t8rn8r/organ-building-for-amateurs/paper organ pipes.odt

# Wicks’ method to make paper organ pipes

Wicks contrived this system of making organ pipes to make it easier and cheaper for the amateur to build their first organ pipes. These paper pipes are meant to imitate metal pipes, but without the need for expensive and difficult metalworking techniques. Wicks lists several advantages to his system for making paper organ pipes:

- They’re cheap. Really, really cheap.
- They’re very light.
- They’re easy to make.
- They require no special tools.
- They have no risk of air leakage since they don’t have long seams.
- They take up the same space as metal pipes.
- They are stronger than metal pipes, and aren’t as easily damaged.
- You can test your pipes before their completion to ensure they will sound.

In practice, this technique has been used in some historical organs, but hasn’t been widely adopted by any major organ builder that I know of. Regardless, making paper pipes is a great way to get into building your own pipe organ.

## Making your first pipe

Wicks suggests starting by making a single pipe that sounds at G5. In the future, you’ll make several sets of pipes at the same time, but the educational and practical value of making a single pipe before investing time and effort into maximizing efficiency of production far outweighs the small amount of time it takes to make. Consider this the “practice round”. Even if you fail, you’ll still end up with a fun keepsake!

### Using the scale

According to the scale you made in a previous chapter, go to the row for G5 to find that it has a speaking length (the length above the mouth of the pipe) of 8-1/2” and a diameter of 23/32”. Don’t worry too much about getting the diameter of the pipe within a 1/32” tolerance. If you make it 3/4” or 11/16” it will make no audible difference in the finished product.

### Forming a mandrel

You will wrap paper around a mandrel to form your pipe. The mandrel should be the exact diameter of the desired pipe, according to the scale you use. For our pipe of 23/32” diameter, we want to make a mandrel of 23/32”.

First, take a dowel with a diameter smaller than the desired pipe and a length much longer than the desired pipe and wrap paper (from a paper roll) around it until it measures exactly 23/32” in diameter. This paper is not your pipe. It is your mandrel. Wrap it tightly and evenly so that it forms a perfect cylinder.

Once you achieve the desired diameter, cut the paper from the paper roll then glue or tape the edge on your mandrel so that you’re left with a cylinder with the exact diameter of your pipe.

### Calculating circumference

First, let’s do some math. The circumference of the pipe is given by circumference = π × diameter. Therefore, the circumference of this pipe is very close to 2-1/4”. We’ll use this number for the rest of our calculations below.

### Forming the pipe

Now it’s time to make your pipe. Using the paper you intend to use for your pipework, cut a piece that is slightly wider than your finished pipe is long. For G5, which is 8-1/2” long, cut the paper about 9” wide. Cut the paper long enough to go around the mandrel about 4 times around the mandrel. For a circumference of 2-1/4”, that length is 9”. (It’s convenient that this pipe uses a square piece of paper. No other pipes will come out this way.)

Mark the distance one circumference (2-1/4” in this case) from the edge of the paper. You can use measuring tools, or simply wrap the paper once around the mandrel for this. Spread glue on the remaining 7-3/4” of paper and let the glue soak into the paper for a little bit, but don’t let it dry.

Finally, wrap the paper around the mandrel so that the part with no glue is in direct contact with the surface of the mandrel. If you fail to do this, your pipe will be glued to the mandrel and never come off.

Press firmly all around your newly formed pipe while its still on the mandrel. You can do this by rolling it against your workbench like a rolling pin.
