t8rn8r/organ-building-for-amateurs/organ specifications.odt

# Organ specifications

When planning your organ, keep in mind that even a small organ will likely require up to year of steady work to finish. However, a medium or large organ doesn’t require much more time to build than a small one. This is largely due to the fact that the mechanical action of a large organ is the same as that of a small organ. The the most significant additional time investment for building a larger organ is the time required to build the additional pipework.

The following specifications (taken directly from Wicks’ original book) provide a few suggested specifications for your first (and second, and third) organ project. Note that he assumes a manual range of 56 keys, from C2 through G6.

Instrument 1: Rank specifications for a general instrument with a manual range of 56 notes and a pedal range of 25 notes

Rank | Number of Pipes | Range | Tone
Open diapason | 44 | C3-G6 | 8’
Stopped Diapason, bass | 12 | C2-B2 | 8’
Stopped diapason, treble | 44 | C3-G6 | 8’
Flute (for Principal) | 56 | C3-G7 | 4’
Keraulophon (small scale) | 44 | C3-G6 | 8’
Flageolet (for Fifteenth) | 56 | C4-G8 | 2’
Bourdon (pedals) | 25 | C1-C3 | 16’
Total: | 281 | C1-G8
Couplers: | Octave Great to Pedal
Enclosures: | Enclose all in general swell
Size: | ~6’6” wide x 9’ high x 3’ deep
Notes: | There will be room for another stop of 12 notes in the bass, in which a violoncello stop may be inserted. If the Bourdon were omitted, it would greatly reduce the size of the instrument. A nice little instrument could be made from only the first four or five stops.

Instrument 2: Rank specification for a two manual instrument with a manual range of 56 keys and a pedal range of 25 keys

Rank | Number of Pipes | Range | Tone
Great organ
Open diapason | 44 | C3-G6 | 8’
Stopped Diapason, bass | 12 | C2-B2 | 8’
Principal (flute) | 56 | C3-G7 | 4’
Flageolet | 56 | C4-G8 | 2’
Swell organ
Lieblich Gedacht | 56 | C2-G6 | 8’
Keraulophon | 44 | C3-G6 | 8’
Pedal organ
Bourdon | 25 | C1-C3 | 16’
Total: | 293 | C1-G8
Couplers: | Swell to Great Swell to great octave Great to Pedal
Enclosures: | Enclose all in general swell
Size: | ~6’6” wide x 9’ high x 3’6” deep

Instrument 3: Rank specification for a smaller two manual instrument with a manual range of 44 keys and a pedal range of 25 keys

Rank | Number of Pipes | Range | Tone
Great organ
Open diapason | 44 | C3-G6 | 8’
Stopped Diapason, bass | 12 | C2-B2 | 8’
Swell organ
Lieblich Gedacht | 44 | C3-G6 | 8’
Flute (for Principal, small scale) | 44 | C3-G6 | 8’
Total: | 144 | C2-G6
Couplers: | Swell to Great Swell to great octave Octave on Great
Enclosures: | Enclose all in general swell
Size: | ~6’6” wide x 9’ high x 3’6” deep
Notes: | The Pedal Bourdon may, or may not, be added, according to the will of the builder If it is added, also add a coupler for Great to Pedal

## A note on octave couplers

If using octave couplers on any organ, add an octave to each stop they affect so that every note on the keyboard may be affected by the coupler.
