t8rn8r/organ-building-for-amateurs/tools and skills.odt

# Required tools and workspace, skills, and supplies

There’s no project more interesting or fascinating than building a musical instrument. When building pianos, trumpets, saxophones, violins, guitars, or any number of other instruments, most of the fun is taken away from the would-be builder because the actual music-producing parts of the instruments must be manufactured by professionals using tools that are inaccessible to the average person. Not so with the organ! Even thought the pipe organ is the king of instruments, every part of it can be built by a motivated amateur.

## Tools and workspace requirements

Here are the recommended tools and workspace requirements for the amateur organ builder (Table 1.1). If there’s a tool listed here that you’re unfamiliar with, a quick online search will likely provide clarity and a place to procure that tool.

Note that you don’t need to go out and purchase all of these tools at once! You may find it beneficial to acquire them as you have need during your project.

To obtain tools that you don’t already own, try exploring your local “tool library,” makerspace, community workshop, or your next door neighbor’s garage. You never know what you might find!

Local craftsmen and women are often very happy to help a new hobbyist get started safely and quickly.

As a last resort, you can find any of these tools at your local carpentry shop or home improvement store.

Table 1.1: Tools and workspace requirements for amateur organ building

- A workbench, at least 6’ long.
- Assorted clamps for holding parts while working and gluing
- Saws for cutting planks of wood
  - A table saw would be most useful for this purpose
- Planes (either power planer or a set of manual hand planes)
  - If using a power planer, you will likely also want a power jointer
- A router for cutting grooves
- A set of hand chisels
  - 1/4”, 3/8”, 5/8”, and 1-1/4” at the minimum
- 3/8” mortise chisel or mortiser
- A set of gouges
  - at least one 1/2”, and ¾”
- A drill with bits ranging from 3/16” to 1-1/4”
  - an expanding bit is optional
  - get a few very small bits for precision drilling and making starter holes
- Screwdrivers and/or screw driving bits for your drill
- Paint brushes, large and small
- Large T-square (at least 30”)
- Carpenter’s square (9-12”)
- Soldering iron
- Wire cutters
- Round nose pliers
- Needle-nose pliers
- Measuring tools
  - Tape measure
  - Precision calipers (at least 1/32” precision)
- Sharp scissors for cutting paper

## Required supplies

The general supplies needed for building an organ are listed in Table 1.2. This list isn’t exhaustive, but provides a general overview of what will be required.

Table 1.2: General supplies required for amateur organ building

- High quality (furniture quality) hardwood
- Dowels of various diameters and lengths
- Rolls of paper (wicks recommends cartridge paper, but any high quality, sturdy paper will do)
- Pneumatic leather (this is different from normal leather skins)
- Wood glue with brushes and rags to apply the glue
- Paint and/or varnish for sealing paper and/or wooden pipes
- Sandpaper in the full range of grits, from very coarse to very fine

## Recommended skills

This book is intended for people who have never built an organ before. Apart from the construction of pipes, the art of organ building is largely one of making cabinetry. Because of this, Wicks’ original book recommends that the amateur organ builder learn the skills listed in Table 1.3 before endeavoring such a project.

Never fear! All of these skills can be easily and safely learned online, or from a minimally skilled local carpenter. In the worst case scenario, you could learn these skills as you move along in your project. Just be prepared for the likely case that you’ll need a few practice attempts before you achieve mastery.

Table 1.3: Recommended skills for the amateur organ builder

- Ability to use (or learn to use) the tools listed in Table 1.1
- Ability to joint and plane a board
- Joint-making: butt joint, dovetail, and/or mortise and tenon
- Knowledge of how to select good wood for hardwood furniture making
  - Knowledge of how to store wood
