t8rn8r/organ-building-for-amateurs/organ pipe pitches.odt

# Pitches of organ pipes

For the vast majority of ranks of organ pipes, the “tone” of the pipe is indicated by the length of the longest pipe. For most pipes, the longest pipe (for the pitch C2) is 8’ long. If you half the length of that pipe to 4’, you get a pitch an octave higher (C3). If you double the length of that pipe to 16’, you get a pitch an octave lower (C1).

Organ builders take advantage of this fact to produce different sound qualities for different sets of pipes. If you use a stop labeled “8’” then play C4 on the keyboard, you will hear C4, but if you use a stop labeled “4’” and play the same key, you will actually hear C5.

Even if the actual lengths of pipes varies from the traditional 8’ standard (see the following sections), as long as the pipe plays the traditional 8’ pitch, that stop will be labeled “8’”.

## Stopped vs open pipes

In this book, you’ll note in subsequent chapters that the length of pipe planned for our projects goes only to 4’ long for the manual stops even though we will make pipes that sound at an 8’ tone. Without going too much into acoustical science, just note for now that stopped pipes (pipes with a plug on their end) sound one octave lower than their open counterparts. This means that for the 8’ pitches in octave 2, you will make the pipes according to the 4’ dimensions, but with a stopper.
