t8rn8r/organ-building-for-amateurs/preface.odt

Preface

This book isn’t written to tell you everything ever written about organ building. This book is for an intelligent amateur interested in building a small pipe organ without any fancy electropneumatic action. It covers everything that’s practically necessary for an at-home crafter to build an organ.

When a generally crafty person catches the organ-building bug, they’re met with a lot of resources that are overly technical, overly theoretical, or assume that the builder has a large body of background knowledge about organ building. This is not one of those books.

On the other hand, when reading introductory material about the function of the pipe organ, the information that’s readily available is overly general, overly vague, and assumes that the would-be builder has the approximate technical skill of the average two-year-old. This is not one of those resources.

Organ construction is widely interesting to a broad range of people, but there currently aren’t any books written to the average, motivated amateur of the 21st century. This is that book.

This book is largely a rewrite of Mark Wicks’ Organ Building for Amateurs, but updates it for use in this century. It will cover his method for making organ pipes from paper, which is cheap and effective, but also explores other more recent manufacturing techniques.

Building even a small, simple organ is of such personal, educational, engineering, and artistic value that it is guaranteed to enrich the life of any amateur with the care, patience, and perseverance to actually accomplish such an impressive task. I genuinely hope that this book will provide years of enrichment to the lives of all who read and follow it.

February 2023.
