t8rn8r/organ-building-for-amateurs/(list of files, cad)

Other CAD files:
pipe scale.dxf
